martonmiklos/robomow_rm_510_mainboard_schematic/odometer_board.png

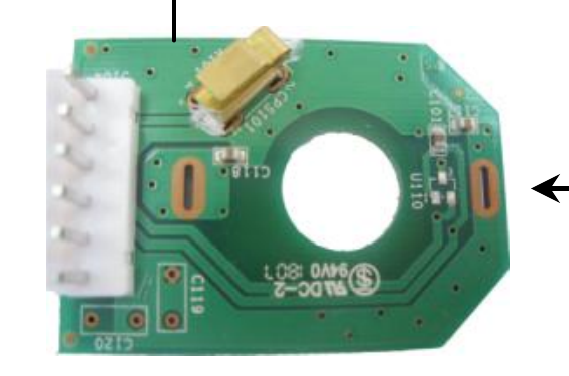
odometer_board.png
