martonmiklos/robomow_rm_510_mainboard_schematic/odometer_sensor.png

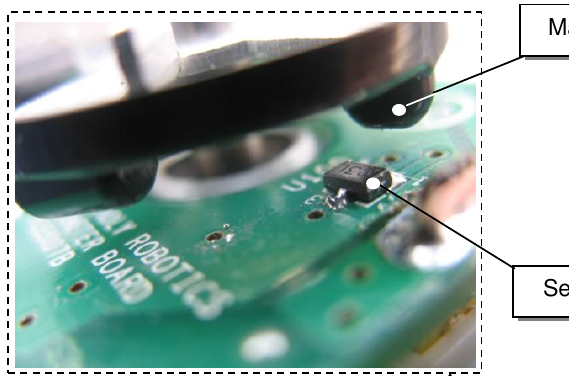
odometer_sensor.png
