martonmiklos/robomow_rm_510_mainboard_schematic/(threads)

Thread 1 (2022-09-28):

RM510 service menu access

katzenberger, 2022-09-28:
Hi,
I'm trying to repair a Robomow RM510, and your schematic is a huge help.
My question is, how did you enter into the service menu to test the motors? It ask me to enter a 5 digit password.

Thank you,
Peter

martonmiklos, 2022-09-28:
Hi @katzenberger

01210 is the master code.
There is a service manual for the RM series floating online, it could be helpful for you:
https://www.dropbox.com/s/6xf6s2zh5ikirl9/Robomow%20RM-510%20Service%20manual.pdf?dl=0

martonmiklos, 2022-09-28:
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

Glad to hear, good luck with the repair process!

katzenberger, 2023-05-08:
Hi @martonmiklos!
The attached service manual was a huge help to find the error in my Robomow RM-510. Thank you!

Now, I tried to connect via RJ11 cable to RM toolkit. But it doesn't work. I connected these pins:
RJ11 pin 1 - TTL USB serial GND
RJ11 pin 2 - TTL USB serial Rxd
RJ11 pin 3 - TTL USB serial Txd

(It is an 5V TTL USB-serial PL2303X dongle, but I checked with a CH340G adapter too)

I checked all RJ11 pins with scope, but all RJ11 pins are low in idle. Uart idle is high level in normal cases. Is it an inverted uart signal here?

Thank you,
Peter

martonmiklos, 2023-05-09:
Hi @katzenberger  I actually built a dongle from an FTDI chip for this purpose:

https://github.com/martonmiklos/robomow_usb_adapter

I did not added any inverter, but if IIRC I have inverted the config in the FTDI EEPROM, but let me check and update the README with it.

martonmiklos, 2023-05-09:
I have forgot to add one note for the USB dongle: it works with a twisted pinout cable (physically straight):
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

katzenberger, 2023-05-09:
Thank you @martonmiklos!

I had to invert the rx/tx lines and it works now!

I have an usb-serial adapter with FT232 chip, but I think it is a fake one, bacause I couldn't flash the eeprom with the FTDI tool.

martonmiklos, 2023-05-09:
Thanks @katzenberger
I have updated the README in the USB dongle repo.

martonmiklos, 2024-03-17:
Hi @katzenberger
I just came across this repository:
https://github.com/katzenberger/robomow_rm_toolkit_protocol

I should say a lot of thank you for that!

What was your goal with the reveng?
Have you made some control electronics for your mower?

katzenberger, 2024-03-18:
Hi @martonmiklos

I planned a mower monitoring device with ESP32 over wifi for integrating into my home automation system. Monitoring battery percentage, charging parameters, temperatures, etc.
But due to lack of time, it has not been implemented yet.

I couldn't find anything useful libs or commands for controlling the lawnmower via the service port, so I planned to connect the start/stop buttons directly to the ESP32.

martonmiklos, 2024-03-18:
Many thanks for the answer @katzenberger !

I wanted to drive my robot from ROS, but I ended up with the same conclusion.
I have disassembled the available firmware with IDA, however they not seems to be not handling any extra commands.

Having an IRDA remote emulator + an additional UART for control seems to be the best option for now.

katzenberger, 2024-03-18:
Hi @martonmiklos!

The IRDA remote emulator also works, but it cannot send mowing start/stop commands. So I have to use the built in scheduler now. But my future plan is starting it from my home assistant/home automation system. (depending on rain or sprinkler system usage, etc.)

katzenberger, 2024-03-18:
It is okay, but with the IRDA remote you have to controll the forward/backward left/right directions too. You cannot start the automated mowing process as the physical START button can on the device.

I built an IR emulator, and it worked for me, but I had to controll the mower with the IR remote controller as a RC car. :)

Closed 2024-11-24.

Thread 2 (2024-12-09):

HASS integrations

N0tMy4cc0unt, 2024-12-09:
I saw on another issue that you are aiming for HASS integration. I'm on the same page with you, as I have acquired couple of used rm510 to work on remote location. I just want to let you know that I'm interested into this, so if you think we can team up our effort in this matter - it would be great!

martonmiklos, 2024-12-09:
Hi @N0tMy4cc0unt

In short: I would like to get my mower to work with OpenMower, to achieve it I would need to expose the robot control and diagnostic capabilities to ROS. The factory firmware expose wide range of diganostic capabilities: see the capabilities of the RM tools and other fellows reverse engineered the protocol:
https://github.com/katzenberger/robomow_rm_toolkit_protocol

Unfortunately the factory firmware does not expose any capabilities for controlling the mower motors. Motor test do exists, but those functions cannot be used for precise movement control.
My best bet was using the IR remote signals for controlling the robot:
https://github.com/katzenberger/robomow_rm_ir_remote_emulator
however they are limited and the loop rate is to small to be appropriate for RTK based navigation (someone suggested 50 Hz update rate on the OpenMower's discord).

With the RM tool leak we managed to find robot firmware updates which are unencrypted M16C binaries which could be disassembled (this is how the IR protocol got reverse engineered).

My next idea was to reverse engineer the schematic and writing an alternative firmware to it.

I made some progress recently (I switched over to Kicad after Autodesk killed the good old EAGLE..).
I just pushed my work to the repo.

My body does not really wants to do firmware development with Windows only tools from the 90s without debugger, but at the moment I do not see much other way to it (other than replacing the whole PCB board).

N0tMy4cc0unt, 2024-12-11:
The way lawnmower currently work (by random movements and paths) it delivers pretty amazing results. I do not see much benefit out of introducing more precise control for mowing as grass cutting is not so precise.

In HASS, I'm monitoring charging including parking at base with simple zigbee socket with power metering feature. With that I can tell mower is parked (or not) and what is it's state of battery charging. I can even use it as emergency cut off (from remote) if I need to stop mowing process by simply turning off smart socket (which will cut mains to the base). In near future I might use zigbee dry contact relays to shape areas for mowing (by rerouting boundary wires). So far so good while still keeping it as simple as possible. I'm using mower own built-in scheduler for once-per week scheduled mowing. This is less than ideal as if this schedule is skipped it will wait another week for another attempt. I'm contemplating with every day schedule then to use HASS to break border wire circuit at scheduled time using dry contact zigbee relays to prevent unwanted mowing.

Having mowers on remote location (watched over internet via security cameras) I need remote control (over internet) to manage specific situations (which requires hands on site) - for example controlled mower return into area when it slides outside border wire, controlled obstacle management and resolve stuck situations. Creating over-web-IR-remote seems like a way to go (at least for remote control of limited mower movements).

I've gone trough Arduino code for IR control and list of identified codes, but I'm not sure how to proceed from there as I do not see how to use IR codes from list to put them into Arduino sketch. I do not even know where IR receiver is on mower. I assume it's visible from the front of the mower, but videos on youtube shows that driver with IR remote walks behind mower...?

martonmiklos, 2024-12-11:
> The way lawnmower currently work (by random movements and paths) it delivers pretty amazing results. I do not see much benefit out of introducing more precise control for mowing as grass cutting is not so precise.

I need RTK based navigation for two reasons:
- I do not want to install perimeter wire
- I have slopes where with the random movements got struck (when going to the slope sideways.) With RTK navigation I could constrain the movement direction on the slopes to be perpendicular to the incline.

>  I do not even know where IR receiver is on mower. I assume it's visible from the front of the mower, but videos on youtube shows that driver with IR remote walks behind mower...?

The IR receiver is in the middle of the LED cap between the two LEDs:
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

I think the LED cap reflecting IR properly from all directions.
But if I were you I would wire the simulated IR impulses directly to the motherboard.

N0tMy4cc0unt, 2024-12-12:
> I need RTK based navigation for two reasons

Your reasons are valid. I do not have slopes (I have a few on perimeter wire where occasionally mower slides outside moving area, but I will manage this by moving border elsewhere). I already setup perimeter wires. I would like RTK, but it does seems like a huge effort to me (maybe in later stage).

I'm thinking about putting esp32 board for IR control over WiFi and optionally to expose all diagnostic metric as sensors entities in HASS (voltages, temperatures etc...).

> But if I were you I would wire the simulated IR impulses directly to the motherboard.

Please advice how to do this exactly as I would like to avoid burning circuits (this is the main reason why I aimed for less intrusive way as I can do some soldering work and embedded programming but far from circuit hacks).

Ideally, I would be able to read display content (from LCD) to show remotely to enable better interaction with mower control buttons (which would also be interfaced to esp32).

martonmiklos, 2024-12-12:
> Please advice how to do this exactly as I would like to avoid burning circuits (this is the main reason why I aimed for less intrusive way as I can do some soldering work and embedded programming but far from circuit hacks).

The pinout is:
1. OC signal
2. GND
3. Power

The silkscreen shows the pin 1 next to the device.

N0tMy4cc0unt, 2024-12-13:
I see IR receiver is TSOP1736TB1 (36 kHz):

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

According to [specs sheet](https://github.com/user-attachments/files/18122434/TSOP1730TB1.PDF) it does support variety of protocols:

> Some examples for suitable data format are: NEC Code, Toshiba Micom Format, Sharp Code, RC5 Code, RC6 Code, R–2000 Code, Sony Format (SIRCS).

I do not see what protocol is in use and need to be simulated (by additional esp32 family board)?

martonmiklos, 2024-12-13:
The TSOP1736TB1 is not the exact type of the part I just picket it arbitrarily.

> I do not see what protocol is in use and need to be simulated (by additional esp32 family board)?

See here:

https://github.com/martonmiklos/robomow_rm_ir_remote_emulator/blob/master/robomow_rm_ir_remote_simulator.ino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

You need to send a code encoded with different 0-1 bit lengths.

N0tMy4cc0unt, 2024-12-13:
I understood this is to receive mower IR command codes via serial and to send them via IR (on pin 3).
How to know which codes/commands are supported?
I see only 1 to 6 bytes are encoded, is that all or more needs to be added?

martonmiklos, 2024-12-13:
The IR protocol of the Robomow only supports sending the 6 button's state on the original remote.

N0tMy4cc0unt, 2024-12-13:
Thanks, so I have everything I need to build WiFi IR remote next week!
This is the [video](https://youtu.be/CUsKFl4YYaM?t=23) showing how to use original remote I have found.
Do I need to adjust frequency based on IR receiver?

N0tMy4cc0unt, 2024-12-14:
I will go with IR (for the first version).
I see that commands can be send very fast (like tens of milis), does mower (receiver) have some logic to deal with it and how? Are the commands received queued or discarded? For one command (i.e. "left") how much mower will turn left (angle)? Can multiple commands be combined, i.e. forward+left?

martonmiklos, 2024-12-14:
> I see that commands can be send very fast (like tens of milis),

Do not try to increase the sending interval because it will not work, the mower cannot handle it.

N0tMy4cc0unt, 2024-12-18:
I disconnected main board (assuming it's the one behind keyboard and display (with IR receiver attached) to identify 5 keyboard pins. It went OK, but I'm facing another issue, on battery power message on display is that it's expecting 4 pin codes. This board is from spare mower, never powered before. Do you by any chance know what is this 4 digit code, how to reset, or is it somehow related to all disconnected peripherals?

N0tMy4cc0unt, 2024-12-18:
I'm planning to use ULN2003AN to "simulate" key pressing by esp32, do you think it will be enough? One idea was to use them together with reed relays, but maybe that would be over-engineered?
Do you know from where is most convenient to obtain 5V power supply? If nothing I'm will use 12V from battery wires...

martonmiklos, 2024-12-18:
From my perspective the ULN is an overkill too 😄

>  Do you know from where is most convenient to obtain 5V power supply? If nothing I'm will use 12V from battery wires...

I do not know how much current does the ESP draws, but the 5V is ceated with a D2PAK 7805 on the board what need to dissipate the additional current. I would go with a spearate 5V DCDC converter from the 24V.

N0tMy4cc0unt, 2024-12-20:
I'm having difficult time understanding this encoding:
```
  uint8_t incomingByte = receiveSerialCommand();

  if (incomingByte == '1') {
    body ^= 0xF00000; // safety
  } else if (incomingByte == '2') {
    body ^= 0x0F0000; // mow
  } else if (incomingByte == '3') {
    body ^= 0x00F000; // left
  } else if (incomingByte == '4') {
    body ^= 0x000F00; // backward
  } else if (incomingByte == '5') {
    body ^= 0x0000F0; // right
  } else if (incomingByte == '6') {
    body ^= 0x00000F; // forward
  } else if (incomingByte == '0') {
    body = DEFAULT_BODY; // reset to default
  }
```
If `incomingByte `is never 0, it will never reset to default? Does it mean it support multiple keys pressed at the same time i.e. mow+forward?

N0tMy4cc0unt, 2024-12-22:
Hm, I tested IR code broadcast with complete mower and it does not react to any code 1 to 6 I tried. At this point I do not know how to begin troubleshooting...
I'm using ESP32-C3 so PWM part had to be adjusted (original seems to be for Arduino?).

martonmiklos, 2024-12-22:
> If incomingByte is never 0, it will never reset to default?

This is just a quick and dirty code to test the functionality. It reads a character from UART and transmits it to the rover.

> Does it mean it support multiple keys pressed at the same time i.e. mow+forward?
It should support it, as you see that the 0xF-s are in distinct location in the code train.

> Hm, I tested IR code broadcast with complete mower and it does not react to any code 1 to 6 I tried. At this point I do not know how to begin troubleshooting... I'm using ESP32-C3 so PWM part had to be adjusted (original seems to be for Arduino?).

You tried with Mr. Katzenberger's code right with an LED?
I doubt that it will work out of the box with ESP, as it is using direct register writes for PWM generation.

N0tMy4cc0unt, 2024-12-24:
esp32 converted code follows:

this is `ir_control.h`

```c
#ifndef IR_CONTROL_H
#define IR_CONTROL_H

#include <stdint.h>

// Pin definition
//#define IR_OUTPUT 3 //moved to main.cpp

// Bit durations (in microseconds)
#define BIT_LEN_H     1000
#define BIT_LEN_L     500

// Default body value
#define DEFAULT_BODY  0xAAAAAA

extern bool irState;
extern uint32_t body;

/**
 * @brief Initializes the infrared modulation system
 */
void modulateCarrier(bool oscOn);

/**
 * @brief Toggles the state of the IR signal modulation
 */
void toggleSignalLevel();

/**
 * @brief Sends data bits using IR modulation
 * @param data Data to send
 * @param bits Number of bits to send
 */
void sendDataBits(uint32_t data, uint8_t bits);

/**
 * @brief Generates a new body value based on the serial command
 * @param prevBody The previous body value
 * @return The new body value
 */
uint32_t generateBodyFromSerialCommand(uint32_t prevBody);

#endif // IR_CONTROL_H
```
this is `ir_control.cpp`

```ir_control.cpp
#include "ir_control.h"
#include <Arduino.h>

bool irState = false;
uint32_t body = DEFAULT_BODY;

const int pwmFrequency = 38400;   // PWM frequency in Hz
const int pwmResolution = 8;      // PWM resolution (8-bit, values 0-255)
const int pwmChannel = 0;         // PWM channel (use a free channel)

void modulateCarrier(bool oscOn)
{
  if (oscOn) {
    // Enable PWM signal using ESP32's LEDC (PWM) functions
    //ledcWriteTone(pwmChannel, pwmFrequency);  // Set PWM frequency
    ledcWrite(pwmChannel, 128);  // Set 50% duty cycle (range: 0-255)
  } else {
    // Turn off PWM signal
    ledcWrite(pwmChannel, 0);  // Set duty cycle to 0
  }
}

void toggleSignalLevel() {
  irState = !irState;
  Serial.print(irState);
  modulateCarrier(irState);
}

void sendDataBits(uint32_t data, uint8_t bits) {
  String logMessage = "";  // Variable to store the log messages

  for (uint8_t i = 0; i < bits; i++) {
    if (data & ((uint32_t)1u << i)) {
      logMessage += "H";  // Append "H" for high signal
      delayMicroseconds(BIT_LEN_H);  // Wait for the high duration
    } else {
      logMessage += "L";  // Append "L" for low signal
      delayMicroseconds(BIT_LEN_L);  // Wait for the low duration
    }

    toggleSignalLevel();  // Toggle the signal level (modulate IR signal)
  }

  // Print the log message after the loop to avoid interference with modulation
  Serial.println(logMessage);
}

uint32_t generateBodyFromSerialCommand(uint32_t prevBody) {
  // Implement your logic to generate body data if needed
  return prevBody; // Placeholder return value
}
```
I tested esp32 code with lawnmower without perimeter wire signal (no signal wire warning shown on lcd display) and no response at any of 0..6 digits sent via serial... I updated code to emit IR for given digit as many time in 5s window following each key send.

martonmiklos, 2024-12-25:
I do not think that sending PWM with software timing is a good idea. Do you happen to have a logic analyzer?

N0tMy4cc0unt, 2024-12-25:
No logic analyzer :(
I was not under impression ESP32's LEDC (PWM) functions are software based, need to look into that...
I removed all prints to serial during IR sending I used for debug. No result. Now I suspect LED brightness is issue as it's brightness is much weaker (looking trough phone camera) then on other IR remotes I had at hand to compare (Air condition, TV). I will try to push more current trough it (50mA) to see if that was the issue.
What makes more difficult for me is that I do not know how actually mower is behaving when driven by remote, I do not know when it will accept IR commands, how it will signal reception is OK, what are prerequisites....

martonmiklos, 2024-12-25:
Grab an Arduino an try out Katzenberger's code to see that the HW part working. Then move onto the ESP stuff.

N0tMy4cc0unt, 2024-12-25:
It works! I need to look into my ESP adaptations...

martonmiklos, 2024-12-25:
Great to hear. I would recommend buying a 5 USD FX2 based logic analyzer board which could be used with Pulseview.
