martonmiklos/robomow_rm_510_mainboard_schematic/Robomow_PCG5000G1.pdf

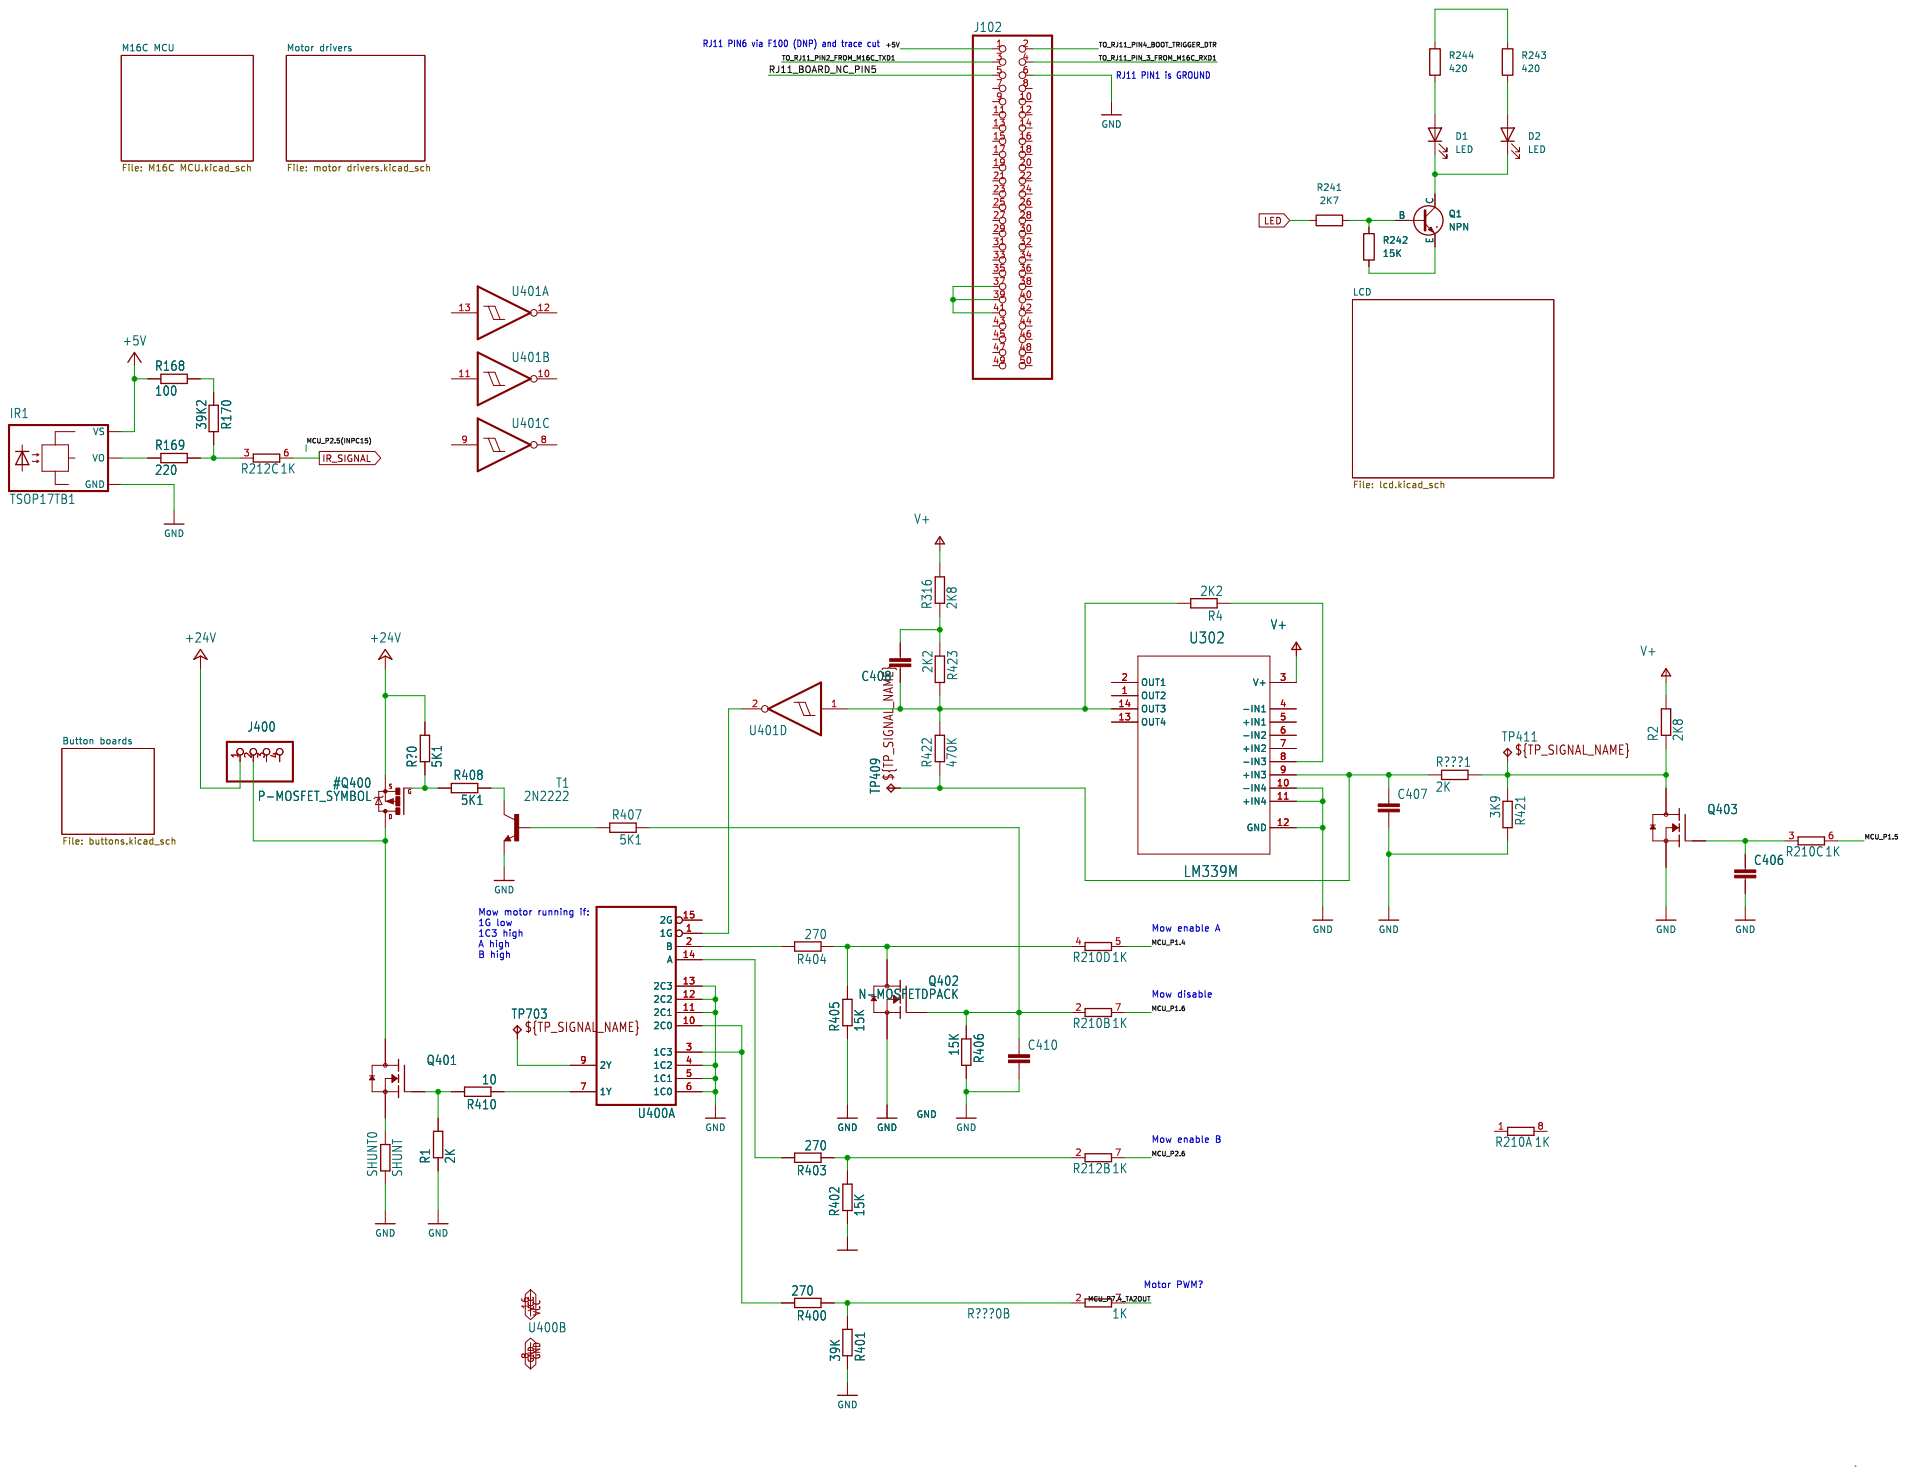
[picture p4: page 1]

RJ11 PIN6 via F100 (DNP) and trace cut

M16C MCU
File: M16C MCU.kicad_sch Button boards File: buttons.kicad_sch

MCU_P1.5 MCU_P7.4_TA2OUT
MCU_P1.6 Mow enable A Mow disable Mow enable B

Motor PWM? Mow motor running if: 1G low

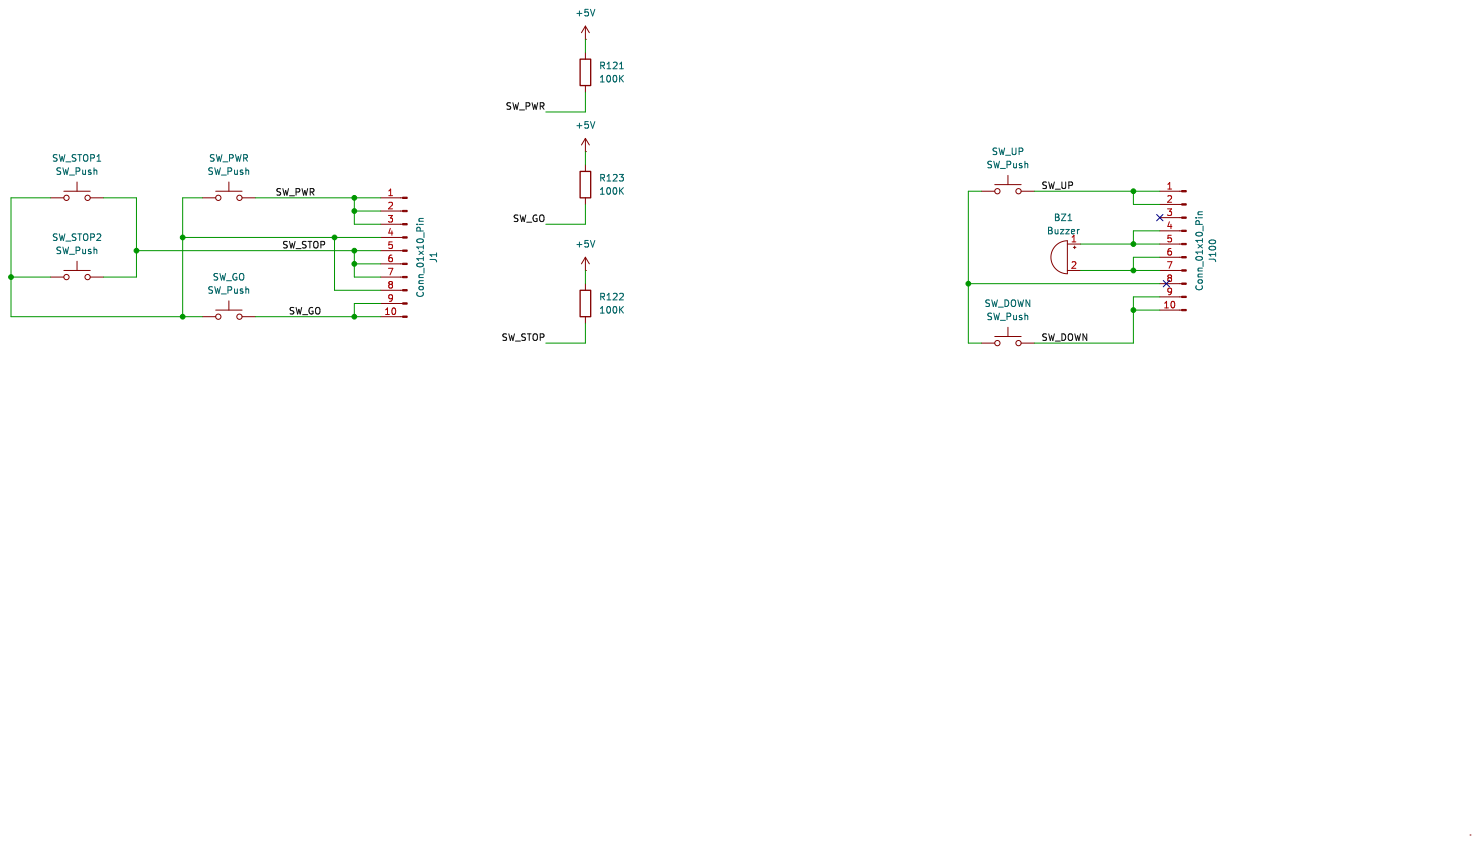
[picture p5: page 2]

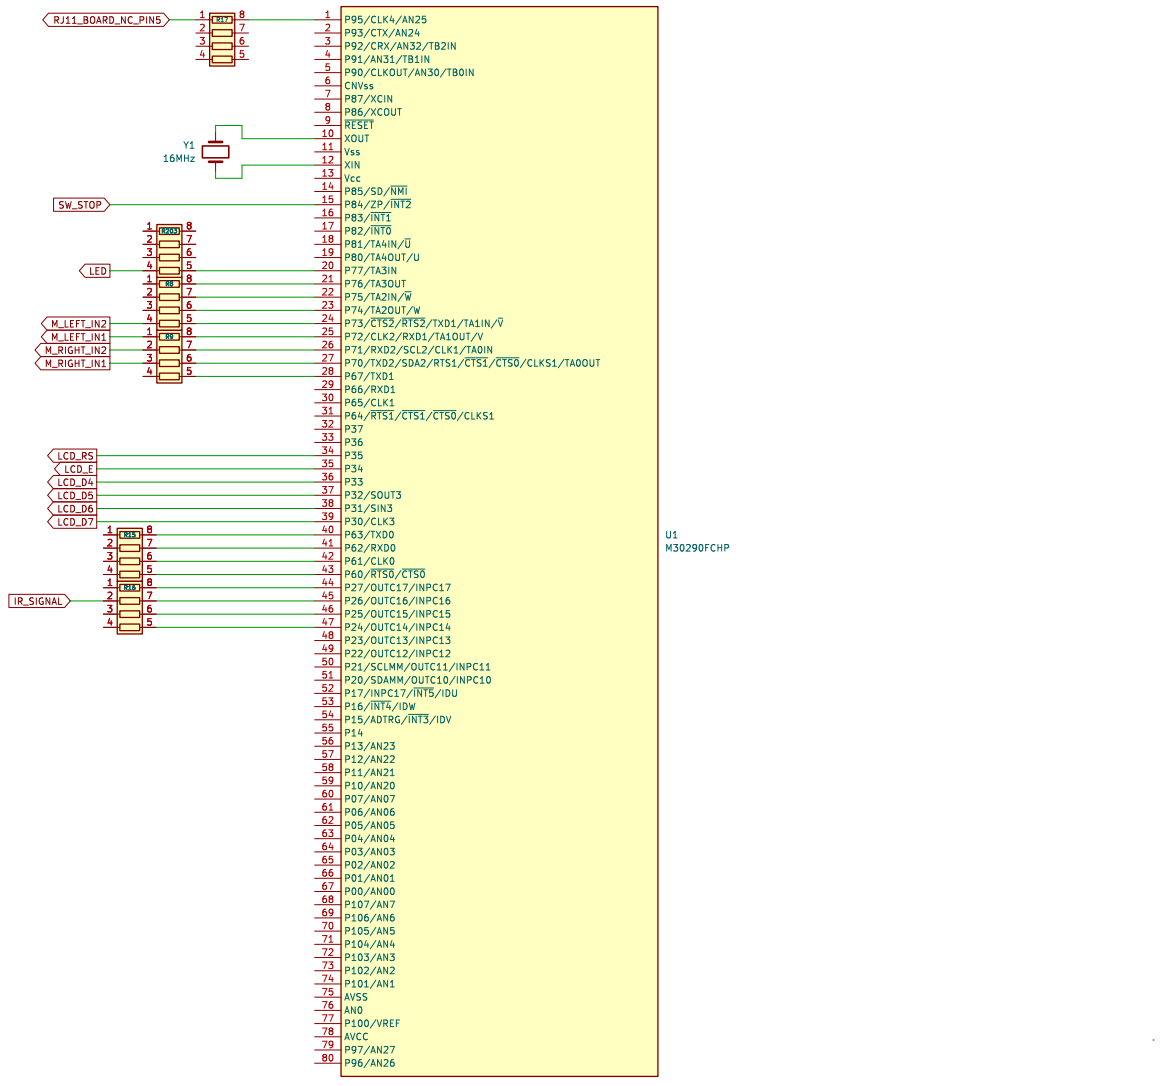
[picture p6: page 3]

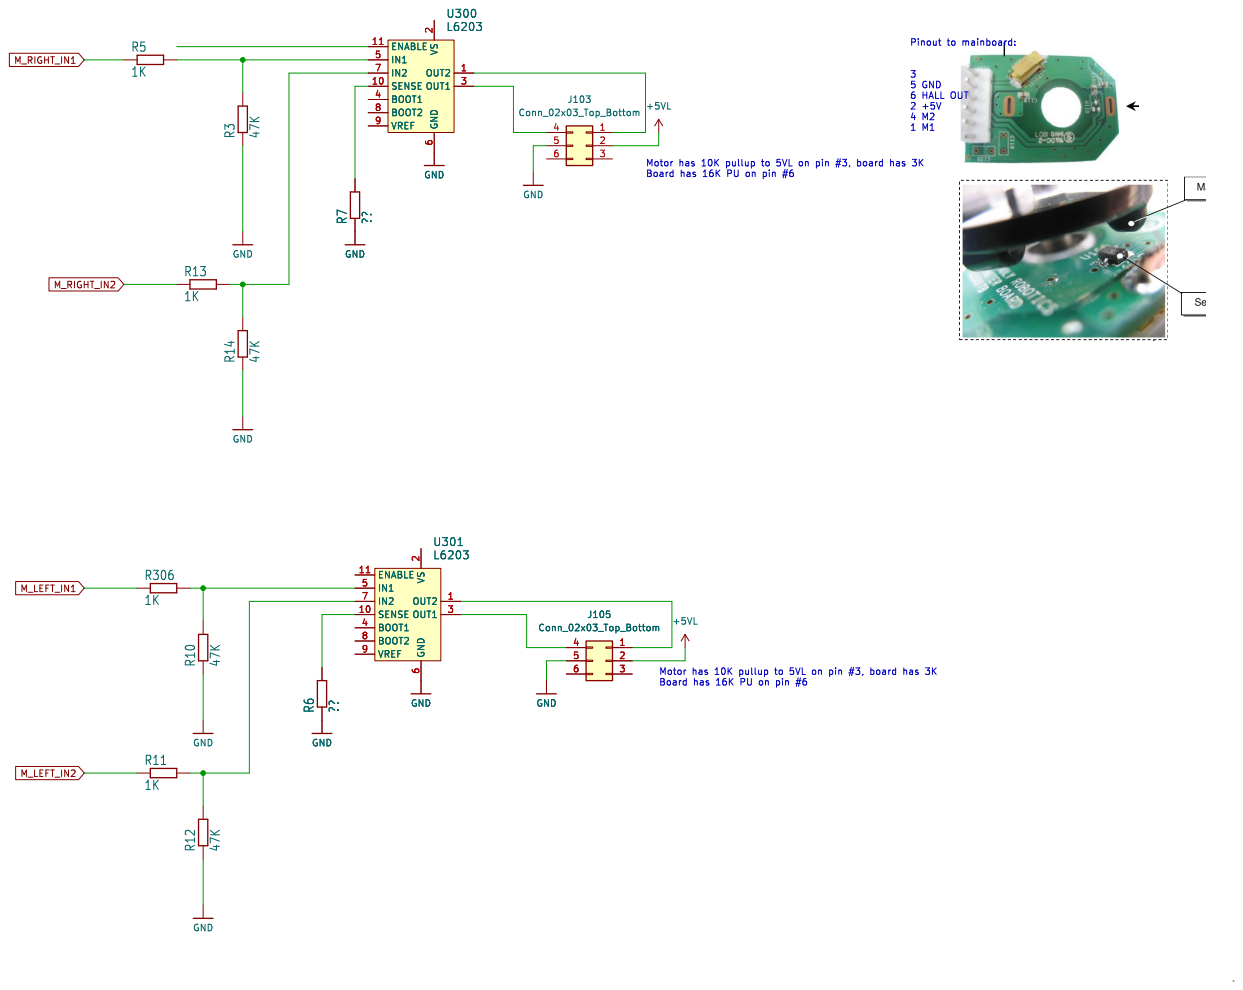
[picture p7: page 4]

1 M1 Motor has 10K pullup to 5VL on pin #3, board has 3K

Board has 16K PU on pin #6

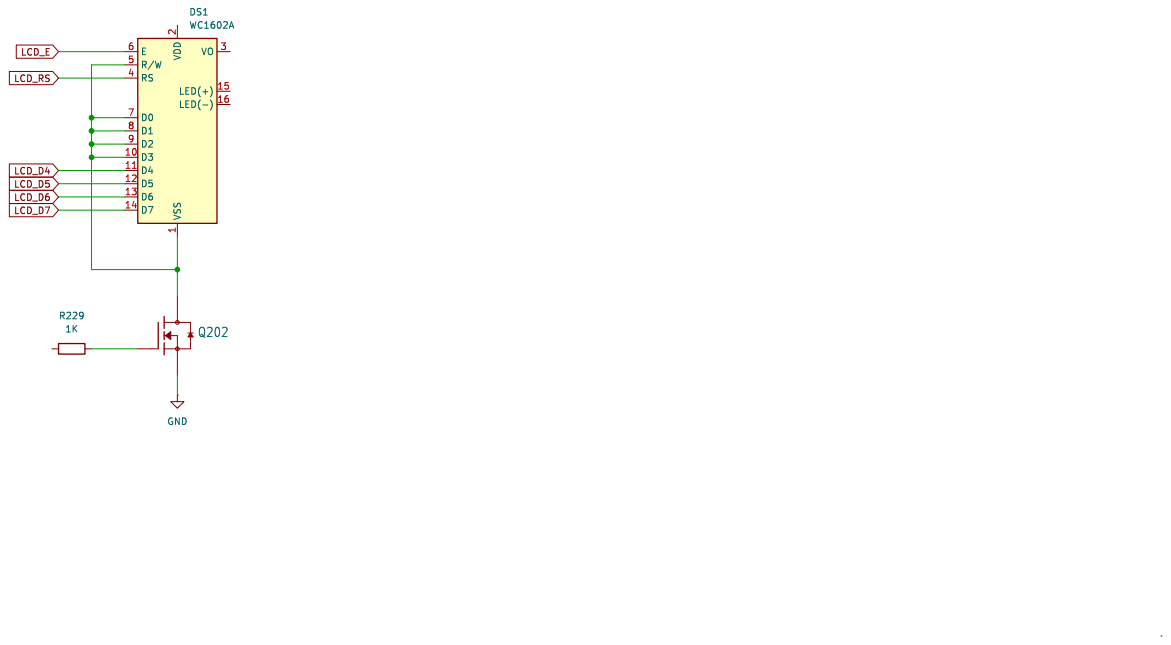
[picture p8: page 5]
