martonmiklos/robomow_rm_510_mainboard_schematic/M16C MCU.kicad_sch

## KiCad design M16C MCU.kicad_sch (2024-12-09)

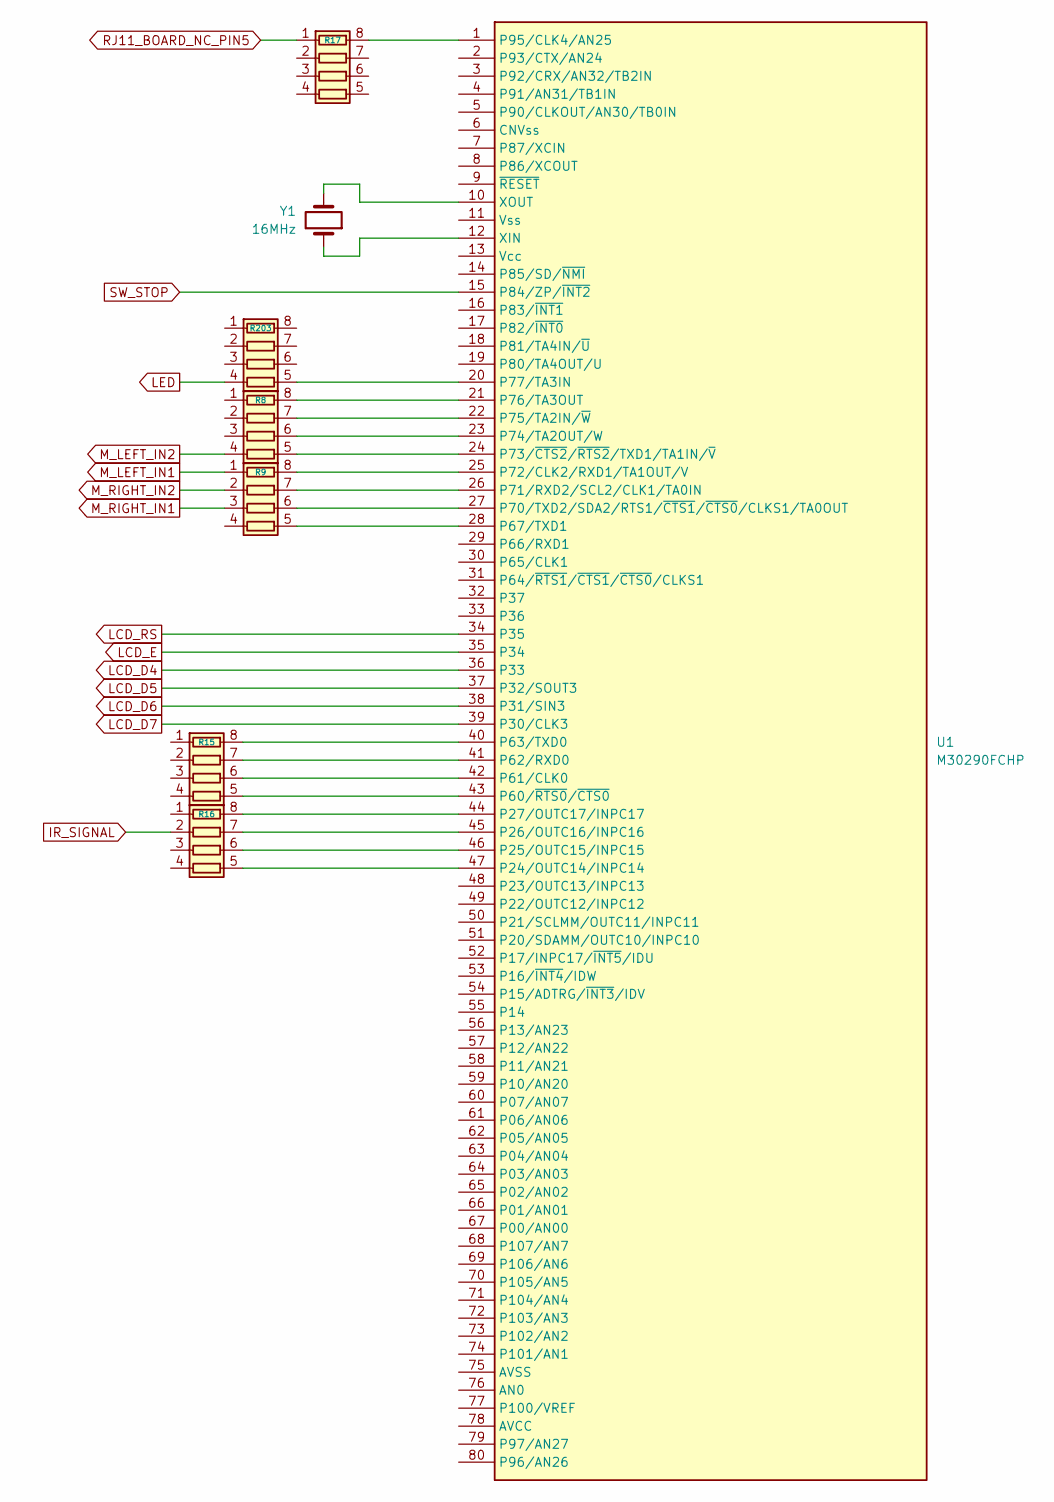
[picture p9: schematic M16C MCU.kicad_sch]

Parts:
R8, R9, R15, R16, R17, R203: R_Pack04
U1: M30290FCHP
Y1: 16MHz

Connections:
IR_SIGNAL: R16.2 (R2.1)
LCD_D4: U1.36 (P33)
LCD_D5: U1.37 (P32/SOUT3)
LCD_D6: U1.38 (P31/SIN3)
LCD_D7: U1.39 (P30/CLK3)
LCD_E: U1.35 (P34)
LCD_RS: U1.34 (P35)
LED: R203.4 (R4.1)
M_LEFT_IN1: R9.1 (R1.1)
M_LEFT_IN2: R8.4 (R4.1)
M_RIGHT_IN1: R9.3 (R3.1)
M_RIGHT_IN2: R9.2 (R2.1)
unnamed: R8.5 (R4.2), U1.24 (P73/~CTS2/~RTS2/TXD1/TA1IN/~V)
unnamed: R8.6 (R3.2), U1.23 (P74/TA2OUT/W)
unnamed: R8.7 (R2.2), U1.22 (P75/TA2IN/~W)
unnamed: R8.8 (R1.2), U1.21 (P76/TA3OUT)
unnamed: R9.5 (R4.2), U1.28 (P67/TXD1)
unnamed: R9.6 (R3.2), U1.27 (P70/TXD2/SDA2/RTS1/~CTS1/~CTS0/CLKS1/TA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)
unnamed: R9.7 (R2.2), U1.26 (P71/RXD2/SCL2/CLK1/TA0IN)
unnamed: R9.8 (R1.2), U1.25 (P72/CLK2/RXD1/TA1OUT/V)
unnamed: R15.5 (R4.2), U1.43 (P60/~RTS0/~CTS0)
unnamed: R15.6 (R3.2), U1.42 (P61/CLK0)
unnamed: R15.7 (R2.2), U1.41 (P62/RXD0)
unnamed: R15.8 (R1.2), U1.40 (P63/TXD0)
unnamed: R16.5 (R4.2), U1.47 (P24/OUTC14/INPC14)
unnamed: R16.6 (R3.2), U1.46 (P25/OUTC15/INPC15)
unnamed: R16.7 (R2.2), U1.45 (P26/OUTC16/INPC16)
unnamed: R16.8 (R1.2), U1.44 (P27/OUTC17/INPC17)
unnamed: R17.8 (R1.2), U1.1 (P95/CLK4/AN25)
unnamed: R203.5 (R4.2), U1.20 (P77/TA3IN)
unnamed: U1.10 (XOUT), Y1.2
unnamed: U1.12 (XIN), Y1.1
RJ11_BOARD_NC_PIN5: R17.1 (R1.1)
SW_STOP: U1.15 (P84/ZP/~INT2)
