martonmiklos/robomow_rm_510_mainboard_schematic/Robomow_PCG5000G1.sch

## EAGLE design Robomow_PCG5000G1.sch (2022-10-02)

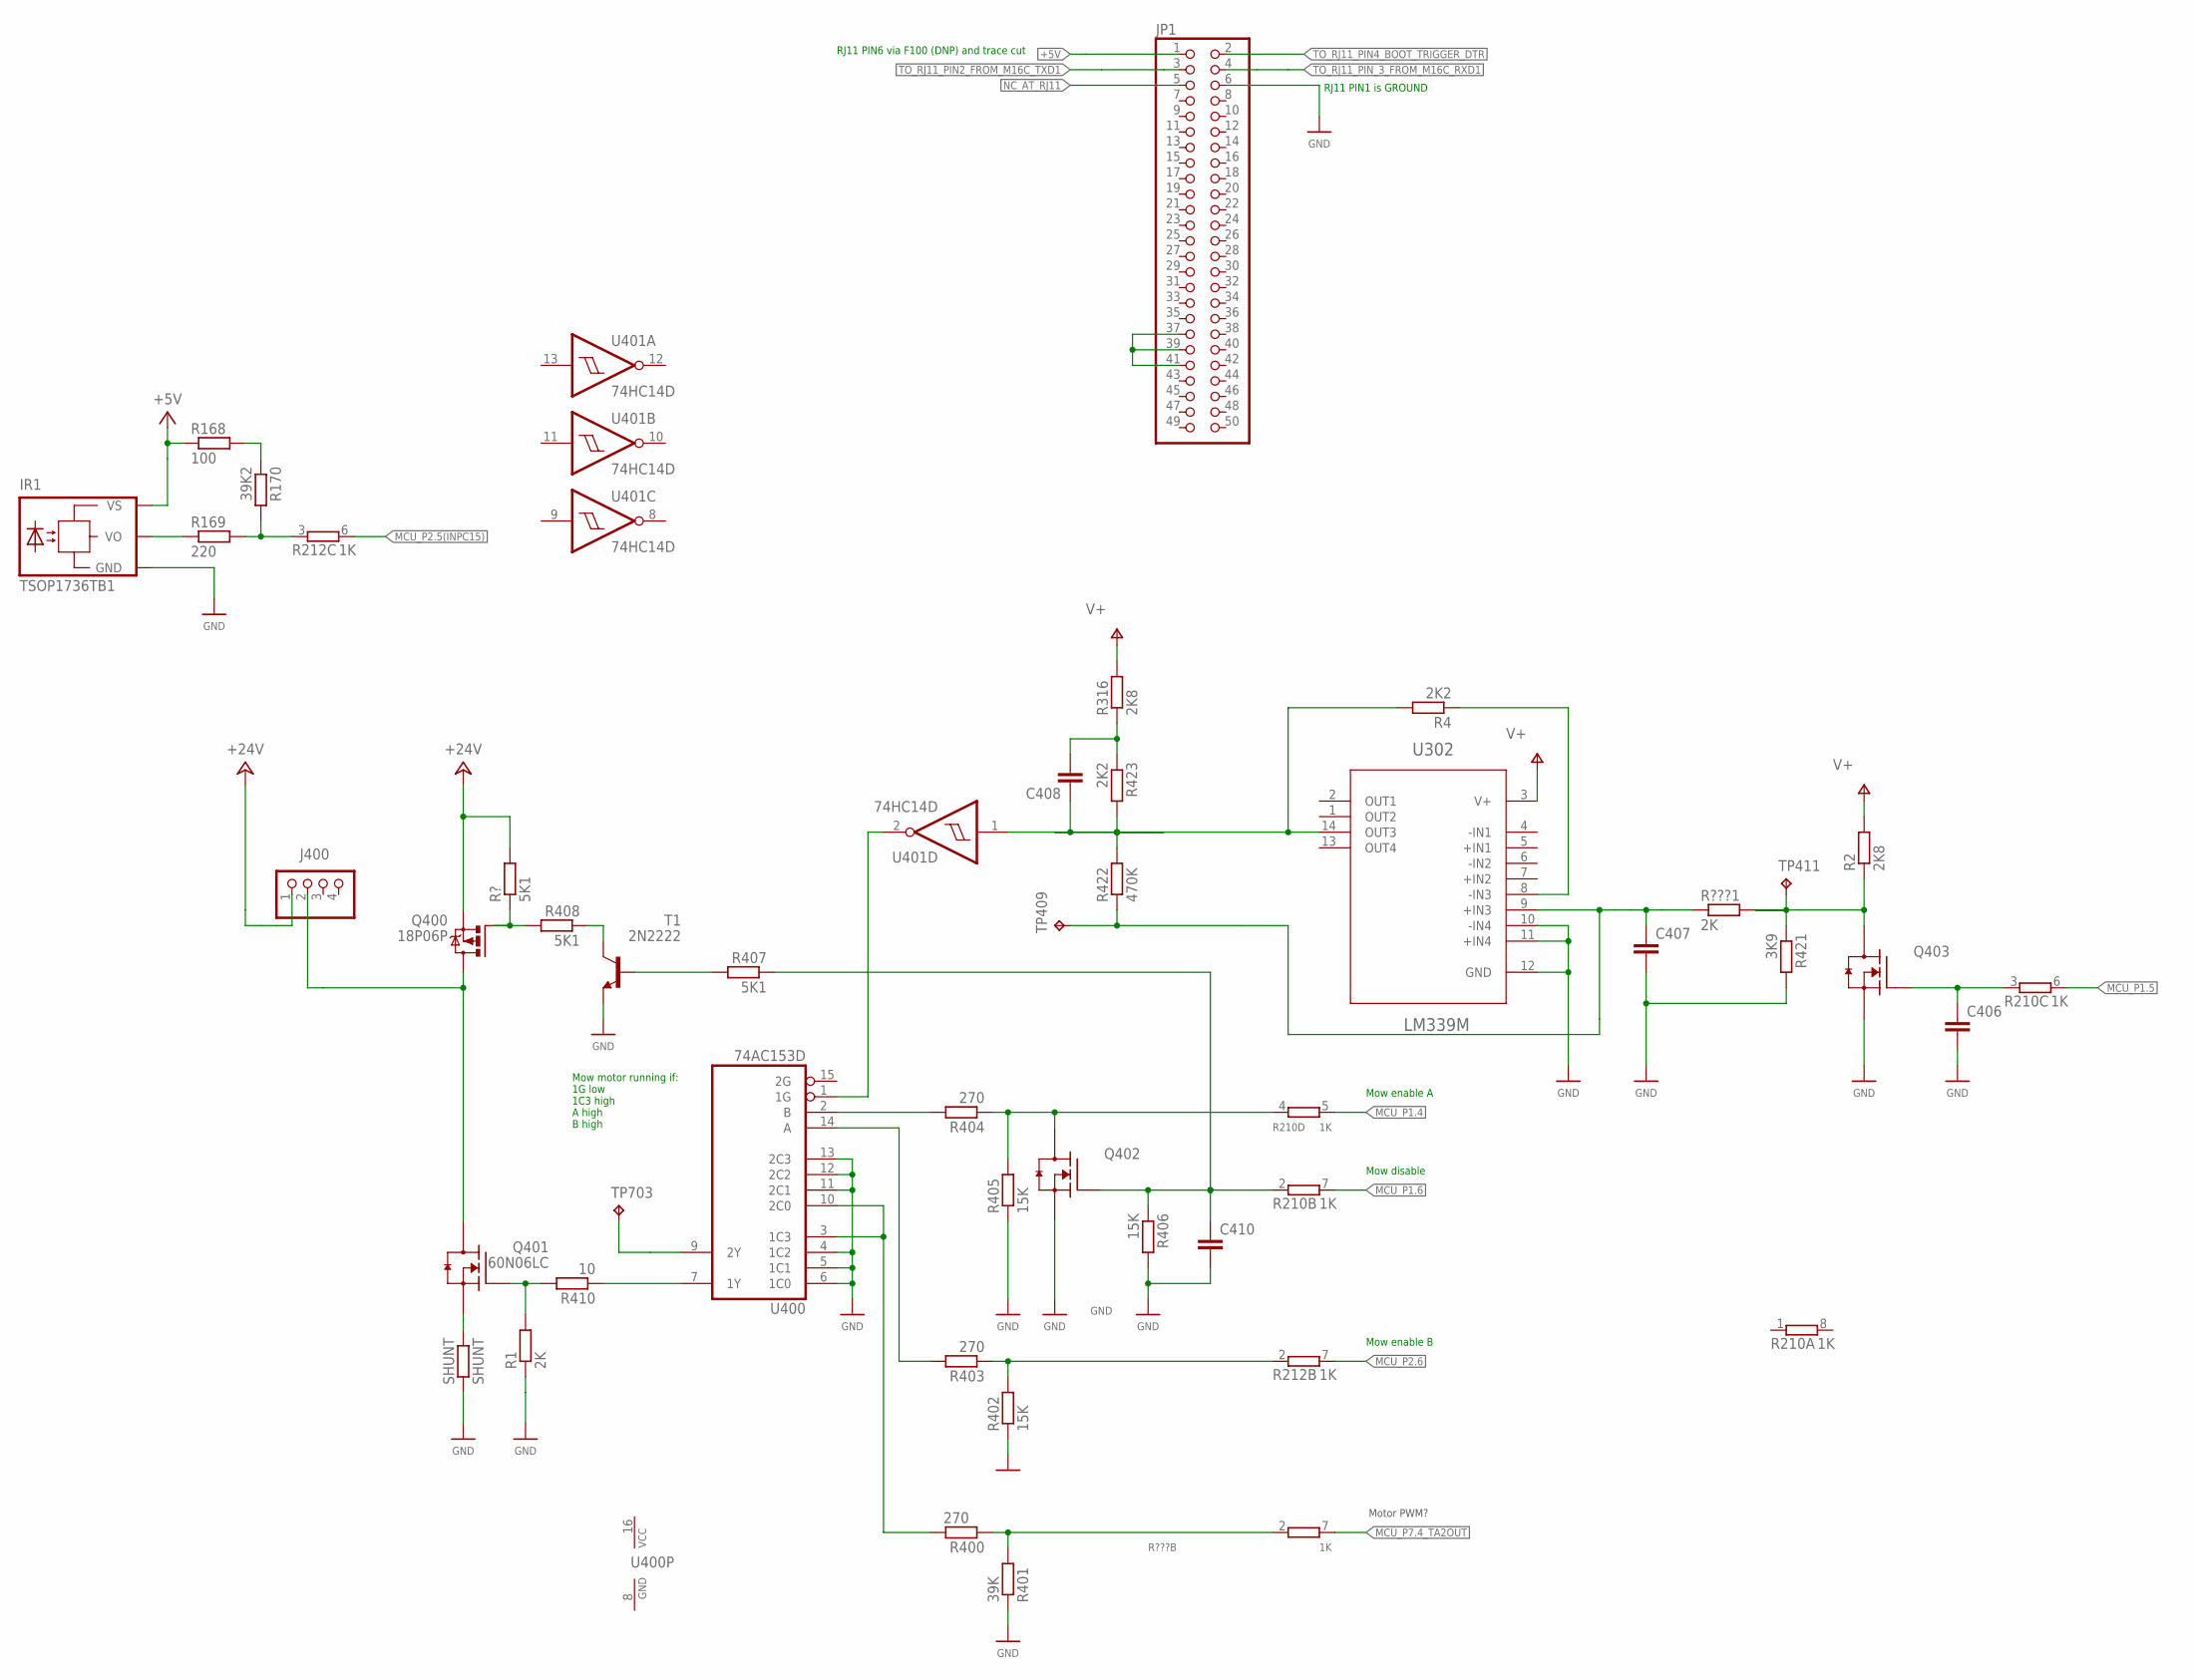
[picture p11: schematic Robomow_PCG5000G1.sch]

Parts:
C406, C407, C408, C410: C-EUC0603; C0603
IR1: TSOP1736TB1; TSOP17_TB1
J400: PINHD-1X4; 1X04
JP1: PINHD-2X25; 2X25
Q401: 60N06LC; DPACK
Q402, Q403: N-MOSFETDPACK; DPACK
R1: 2K; R0603
R2, R316: 2K8; R0603
R4, R423: 2K2; R0603
R168: 100; R0603
R169: 220; R0603
R170: 39K2; R0603
R210, R212: 1K; CAT16
R400, R403, R404: 270; R0603
R401: 39K; R0603
R402, R405, R406: 15K; R0603
R407, R408: 5K1; R0603
R410: 10; R0603
R421: 3K9; R0603
R422: 470K; R0603
R?: 5K1; R0603
R???: 1K; CAT16
R???1: 2K; R0603
SHUNT: SHUNT; R0603
T1: 2N2222; TO92-EBC-OVAL
TP409, TP411, TP703: TPB1,27; B1,27
U302: LM339M; SOIC127P620X175-14N
U400: 74AC153D; SO16
U401: 74HC14D; SO14

Connections:
+5V: IR1.VS, JP1.1, R168.1
+24V: J400.1, R?.2
GND: C406.2, C407.2, C410.2, IR1.GND, JP1.6, Q402.3 (S), Q403.3 (S), R1.1, R401.1, R402.1, R405.1, R406.2, R421.2, SHUNT.1, T1.E, U302.10 (-IN4), U302.11 (+IN4), U302.12 (GND), U400.4 (1C2), U400.5 (1C1), U400.6 (1C0), U400.11 (2C1), U400.12 (2C2), U400.13 (2C3)
MCU_P1.4: R210.5 (2)
MCU_P1.5: R210.6 (2)
MCU_P1.6: R210.7 (2)
MCU_P2.5(INPC15): R212.6 (2)
MCU_P2.6: R212.7 (2)
MCU_P7.4_TA2OUT: R???.7 (2)
MOTOR_HALT?: C410.1, Q402.1 (G), R210.2 (1), R406.1, R407.1
MOTOR_HALT?1: C406.1, Q403.1 (G), R210.3 (1)
unnamed: J400.2, Q401.2 (D)
unnamed: Q401.1 (G), R1.2, R410.2
unnamed: R410.1, U400.7 (1Y)
unnamed: R407.2, T1.B
unnamed: C408.1, R4.2, R422.2, R423.2, U302.14 (OUT3), U401.1 (I)
unnamed: TP703.TP, U400.9 (2Y)
unnamed: R212.2 (1), R402.2, R403.1
unnamed: R169.2, R170.2, R212.3 (1)
unnamed: R408.1, T1.C
unnamed: R404.2, U400.2 (B)
unnamed: R403.2, U400.14 (A)
unnamed: R400.1, R401.2, R???.2 (1)
unnamed: R400.2, U400.3 (1C3), U400.10 (2C0)
unnamed: Q403.2 (D), R2.1, R421.1, R???1.2, TP411.TP
unnamed: U400.1 (1G), U401.2 (O)
unnamed: Q401.3 (S), SHUNT.2
unnamed: Q402.2 (D), R210.4 (1), R404.1, R405.2
unnamed: C408.2, R316.1, R423.1
unnamed: JP1.37, JP1.39, JP1.41
unnamed: R4.1, U302.8 (-IN3)
unnamed: C407.1, R422.1, R???1.1, TP409.TP, U302.9 (+IN3)
unnamed: IR1.VO, R169.1
unnamed: R168.2, R170.1
NC_AT_RJ11: JP1.5
Q400_GATE: R408.2, R?.1
TO_RJ11_PIN2_FROM_M16C_TXD1: JP1.3
TO_RJ11_PIN4_BOOT_TRIGGER_DTR: JP1.2
TO_RJ11_PIN_3_FROM_M16C_RXD1: JP1.4
V+: R2.2, R316.2, U302.3 (V+)

Notes on the sheet:
Motor PWM?
Mow motor running if: 1G low 1C3 high A high B high
Mow enable A
Mow enable B
Mow disable
RJ11 PIN1 is GROUND
RJ11 PIN6 via F100 (DNP) and trace cut
