martonmiklos/robomow_rm_510_mainboard_schematic/buttons.kicad_sch

## KiCad design buttons.kicad_sch (2024-12-09)

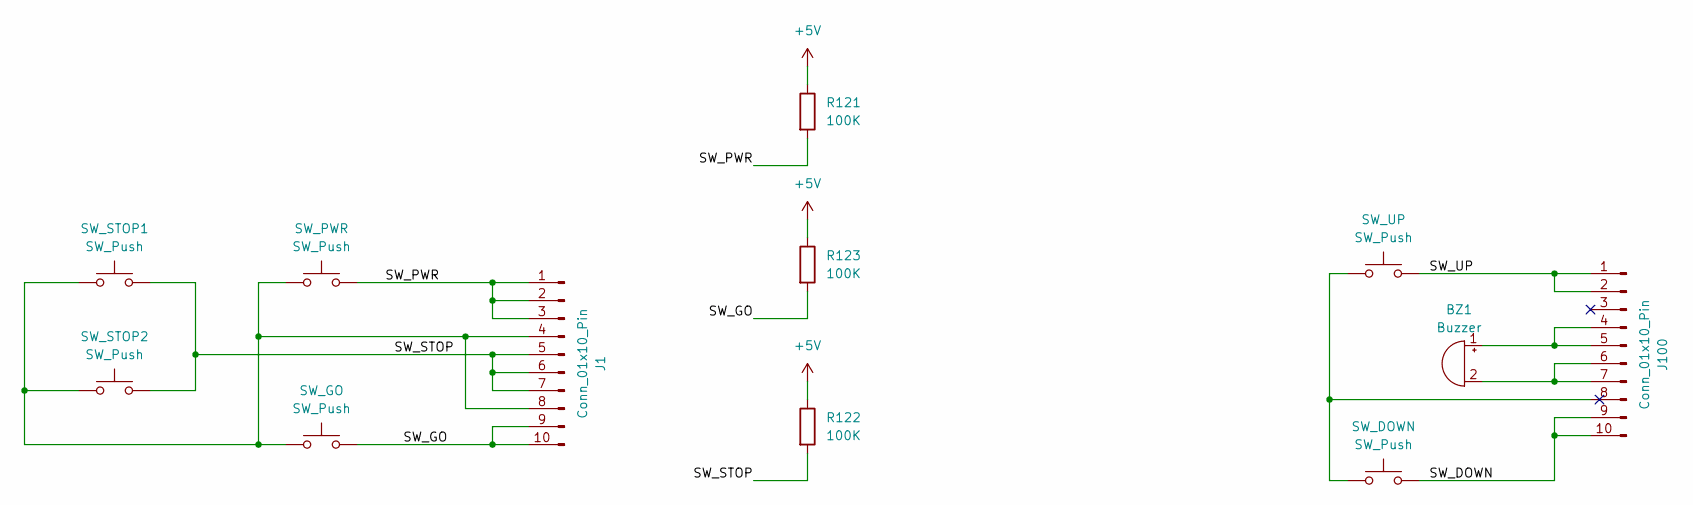
[picture p12: schematic buttons.kicad_sch]

Parts:
BZ1: Buzzer
J1, J100: Conn_01x10_Pin
R121, R122, R123: 100K
SW_DOWN: SW_Push
SW_GO: SW_Push
SW_PWR: SW_Push
SW_STOP1, SW_STOP2: SW_Push
SW_UP: SW_Push

Connections:
+5V: R121.1, R122.1, R123.1
unnamed: BZ1.1 (-), J100.4, J100.5
unnamed: BZ1.2 (+), J100.6, J100.7
unnamed: J1.4, J1.8, SW_GO.1, SW_PWR.1, SW_STOP1.1, SW_STOP2.1
unnamed: J100.8, SW_DOWN.1, SW_UP.1
SW_DOWN: J100.9, J100.10, SW_DOWN.2
SW_GO: J1.9, J1.10, R123.2, SW_GO.2
SW_PWR: J1.1, J1.2, J1.3, R121.2, SW_PWR.2
SW_STOP: J1.5, J1.6, J1.7, R122.2, SW_STOP1.2, SW_STOP2.2
SW_UP: J100.1, J100.2, SW_UP.2
