martonmiklos/robomow_rm_510_mainboard_schematic/lcd.kicad_sch

## KiCad design lcd.kicad_sch (2024-12-09)

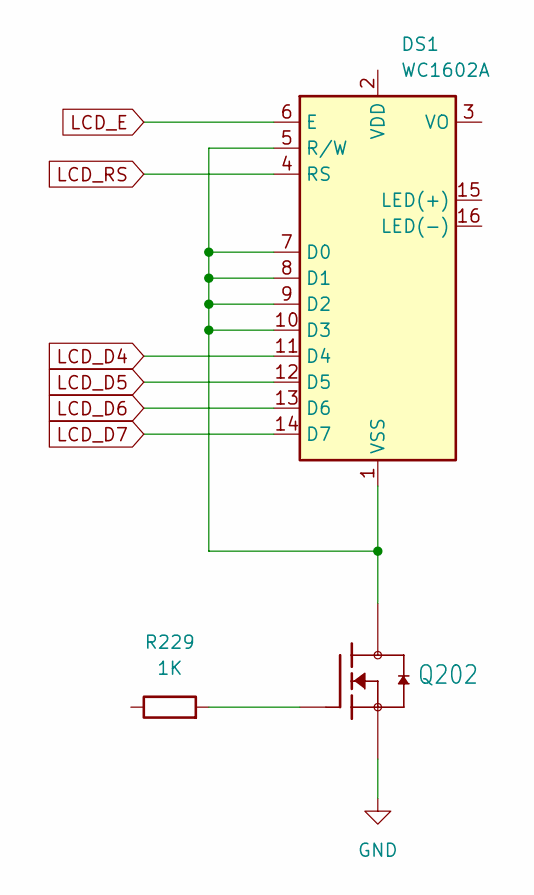
[picture p13: schematic lcd.kicad_sch]

Parts:
DS1: WC1602A
Q202: DPACK
R229: 1K

Connections:
GND: Q202.3 (S)
LCD_D4: DS1.11 (D4)
LCD_D5: DS1.12 (D5)
LCD_D6: DS1.13 (D6)
LCD_D7: DS1.14 (D7)
LCD_E: DS1.6 (E)
LCD_RS: DS1.4 (RS)
unnamed: DS1.1 (VSS), DS1.5 (R/W), DS1.7 (D0), DS1.8 (D1), DS1.9 (D2), DS1.10 (D3), Q202.2 (D)
unnamed: Q202.1 (G), R229.2
