martonmiklos/robomow_rm_510_mainboard_schematic/motor drivers.kicad_sch

## KiCad design motor drivers.kicad_sch (2024-12-09)

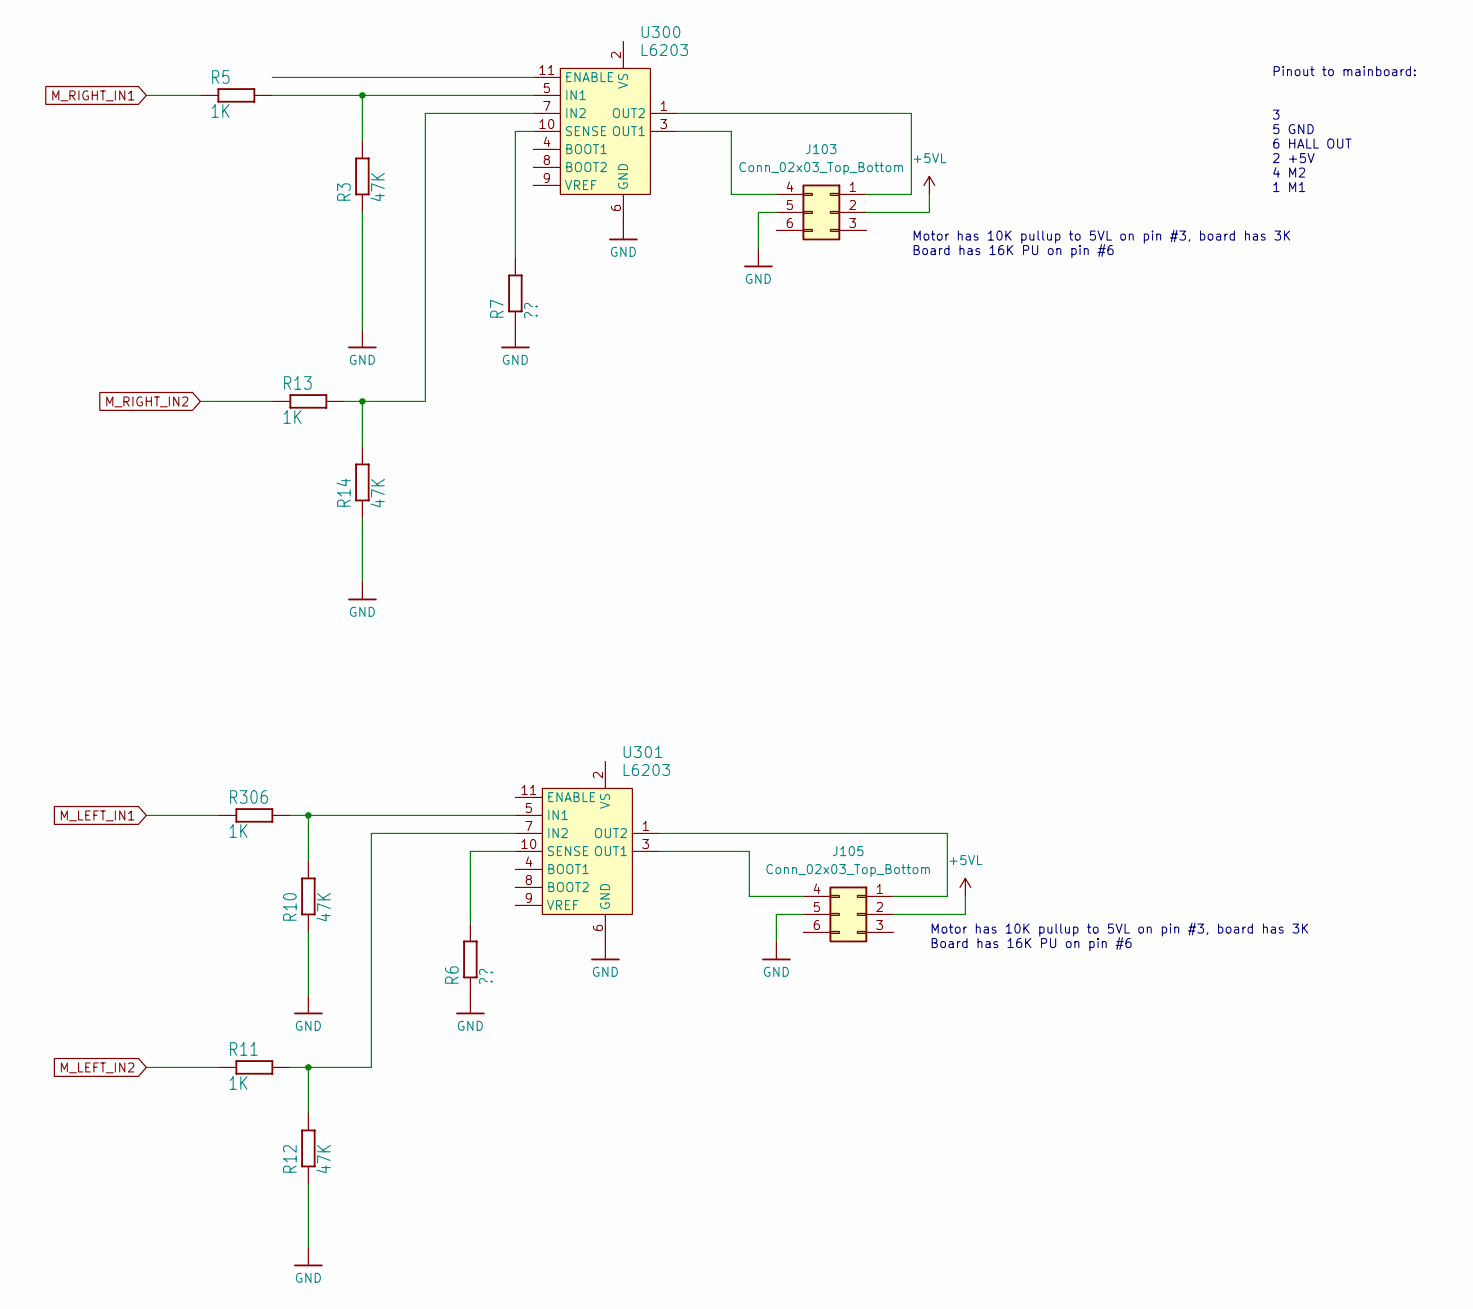
[picture p14: schematic motor drivers.kicad_sch]

Parts:
J103, J105: Conn_02x03_Top_Bottom
R3, R10, R12, R14: 47K; R0603
R5, R11, R13, R306: 1K; R0603
R6, R7: ??; R0603
U300, U301: L6203; Multiwatt-11; MPN L6203; Digi-Key_PN 497-1421-5-ND

Connections:
+5VL: J103.2, J105.2
GND: J103.5, J105.5, R3.1, R6.1, R7.1, R10.1, R12.1, R14.1, U300.6 (GND), U301.6 (GND)
M_LEFT_IN1: R306.1
M_LEFT_IN2: R11.1
M_RIGHT_IN1: R5.1
M_RIGHT_IN2: R13.1
unnamed: J103.1, U300.1 (OUT2)
unnamed: J103.4, U300.3 (OUT1)
unnamed: J105.1, U301.1 (OUT2)
unnamed: J105.4, U301.3 (OUT1)
unnamed: R3.2, R5.2, U300.5 (IN1)
unnamed: R6.2, U301.10 (SENSE)
unnamed: R7.2, U300.10 (SENSE)
unnamed: R10.2, R306.2, U301.5 (IN1)
unnamed: R11.2, R12.2, U301.7 (IN2)
unnamed: R13.2, R14.2, U300.7 (IN2)

Notes on the sheet:
Pinout to mainboard: 3 5 GND 6 HALL OUT 2 +5V 4 M2 1 M1
Motor has 10K pullup to 5VL on pin #3, board has 3K Board has 16K PU on pin #6
