martonmiklos/robomow_rm_510_mainboard_schematic/(commit log)

2020-09-12 Add sch
    [Robomow_PCG5000G1.sch]
2021-08-25 Commit moare reveng
    [Robomow_PCG5000G1.sch]
2021-08-29 Rearranged schematic
    [Robomow_PCG5000G1.sch]
2022-10-02 Added boot trigger pin to the ribbon pinout Thanks Ryan!
    [Robomow_PCG5000G1.sch]
